cmtangeman/textmachine/README.md

# TextMachine
CrankPhone SW/FW/HW/Mech
Notes on directory structure:

FW:

ArduinoILI9341MKNNB1500 :  All for resistive touch FW (old)

capTouchTestingAndCal: testing calibration of capacitive touch

receiveSMSwithDebug:  debug file that doesn't need touchscreen

techmach: FW for old resistive screen

techmachcap: FW for current working capacitive touch screen.  See README.txt in this directory for further info.
