cmtangeman/textmachine/FW/UI_IMAGES/brightness_slider1.png

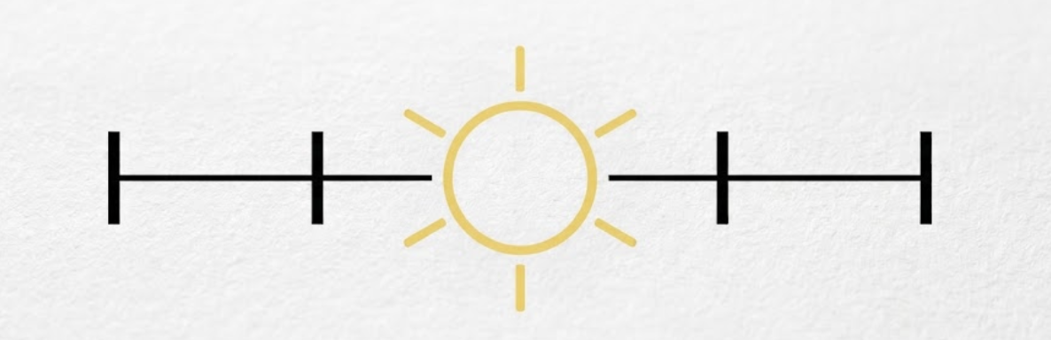
FW/UI_IMAGES/brightness_slider1.png
