cmtangeman/textmachine/FW/UI_IMAGES/compose.png

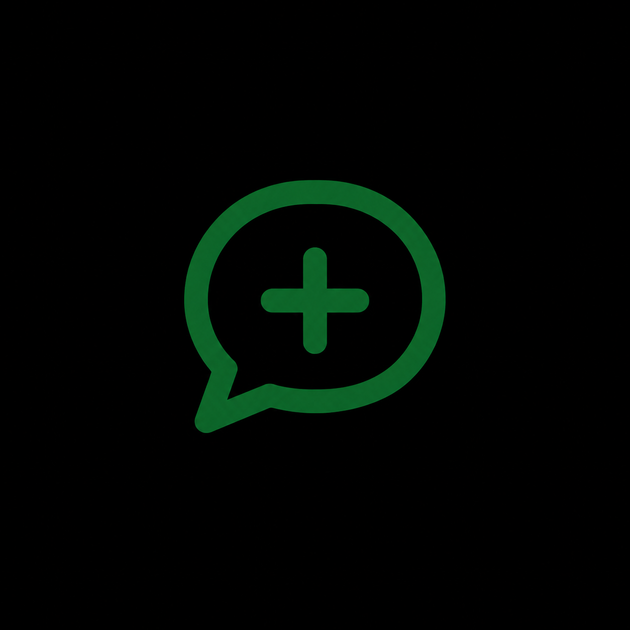
FW/UI_IMAGES/compose.png
