cmtangeman/textmachine/FW/UI_IMAGES/contacts.png

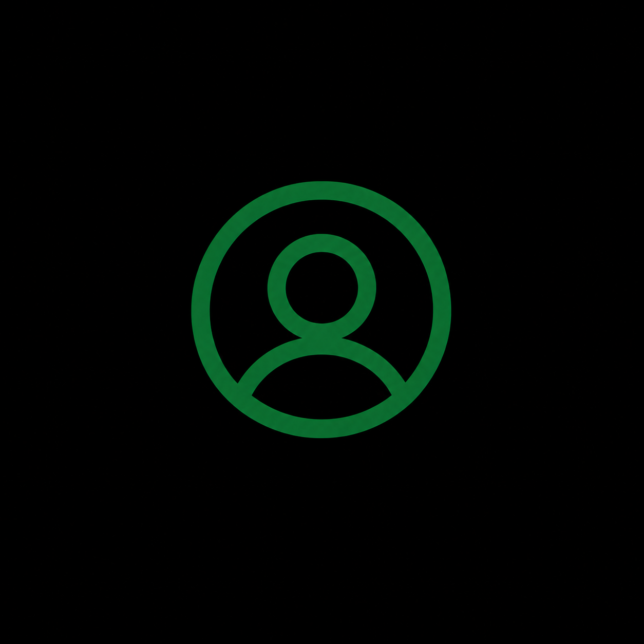
FW/UI_IMAGES/contacts.png
