cmtangeman/textmachine/FW/UI_IMAGES/contacts_only_mode_selector.png

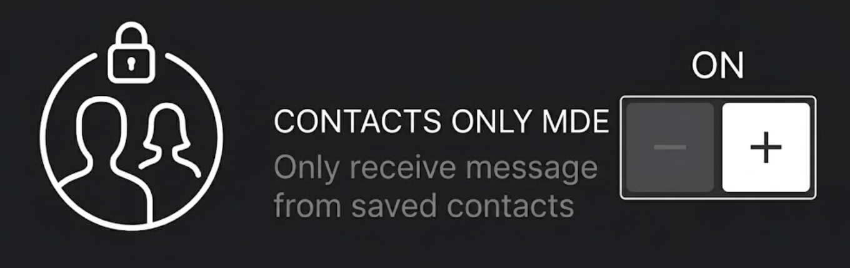
FW/UI_IMAGES/contacts_only_mode_selector.png
