cmtangeman/textmachine/FW/UI_IMAGES/swipe_indicator.png

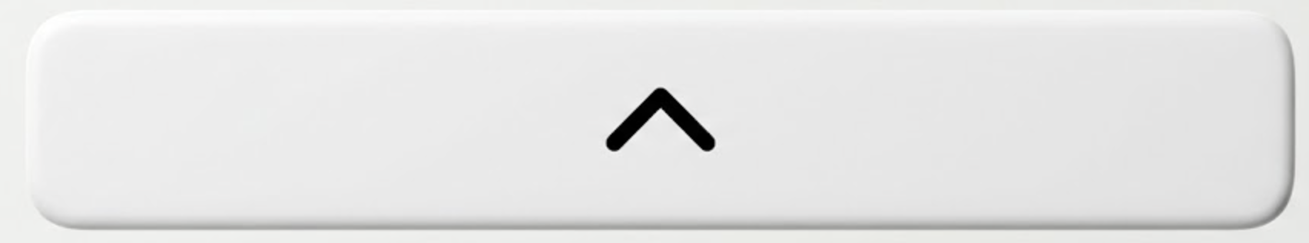
FW/UI_IMAGES/swipe_indicator.png
