cmtangeman/textmachine/(list of files, drawings)

Other design files:
HW/HA_FONA_LARA_20.dsn
