cmtangeman/textmachine/HW/HA_FONA_nonKiCad/HA_FONA_LARA_20.kicad_pcb

## KiCad design HW/HA_FONA_nonKiCad/HA_FONA_LARA_20.kicad_pcb (2026-10-18)

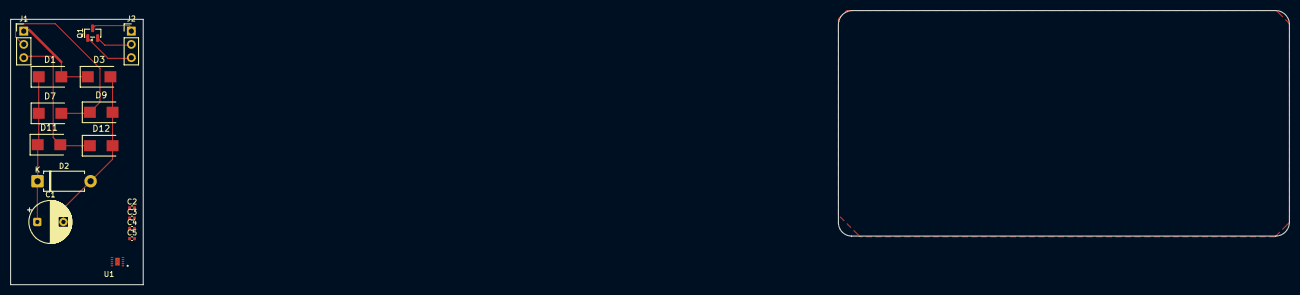
[picture p6: board HA_FONA_LARA_20.kicad_pcb from above]

Board: 2 copper layers, 25.4 x 50.8 mm, 16 parts (0 on the bottom side), 9 nets.

Parts:
C1: C_Polarized; CP_Radial_D8.0mm_P5.00mm
C2: 2.2u; C_0402_1005Metric
C3: 0.1u; C_0402_1005Metric
C4: 10u; C_0402_1005Metric
C5: 1u; C_0402_1005Metric
D1, D3, D7, D9, D11, D12: DIODE; DIOM5336X265N
D2: D; D_DO-15_P10.16mm_Horizontal
J1, J2: Conn_01x03_Pin; PinHeader_1x03_P2.54mm_Vertical
Q1: PMOS; SOT-23
U1: BQ25185DLHR; IC_BQ25185DLHR

Connections:
GND: C1.2, C2.1, C3.1, C4.2, D2.2 (A), D3.2 (A), D9.2 (A), D12.2 (A), U1.5 (GND)
unnamed: D1.2 (A), D3.1 (C), J1.1
unnamed: D7.2 (A), D9.1 (C), J1.2
unnamed: D11.2 (A), D12.1 (C), J1.3
unnamed: J2.1, Q1.3 (S)
unnamed: J2.2, Q1.2 (G)
unnamed: J2.3, Q1.1 (D)
unnamed: C4.1, U1.1 (SYS)
VBAT: C1.1, C2.2, C3.2, D1.1 (C), D2.1 (K), D7.1 (C), D11.1 (C), U1.10 (IN)
