cmtangeman/textmachine/HW/ported_textmachine_test (Copy)/ported_textmachine_test.kicad_pcb

## KiCad design HW/ported_textmachine_test (Copy)/ported_textmachine_test.kicad_pcb (2026-10-17)

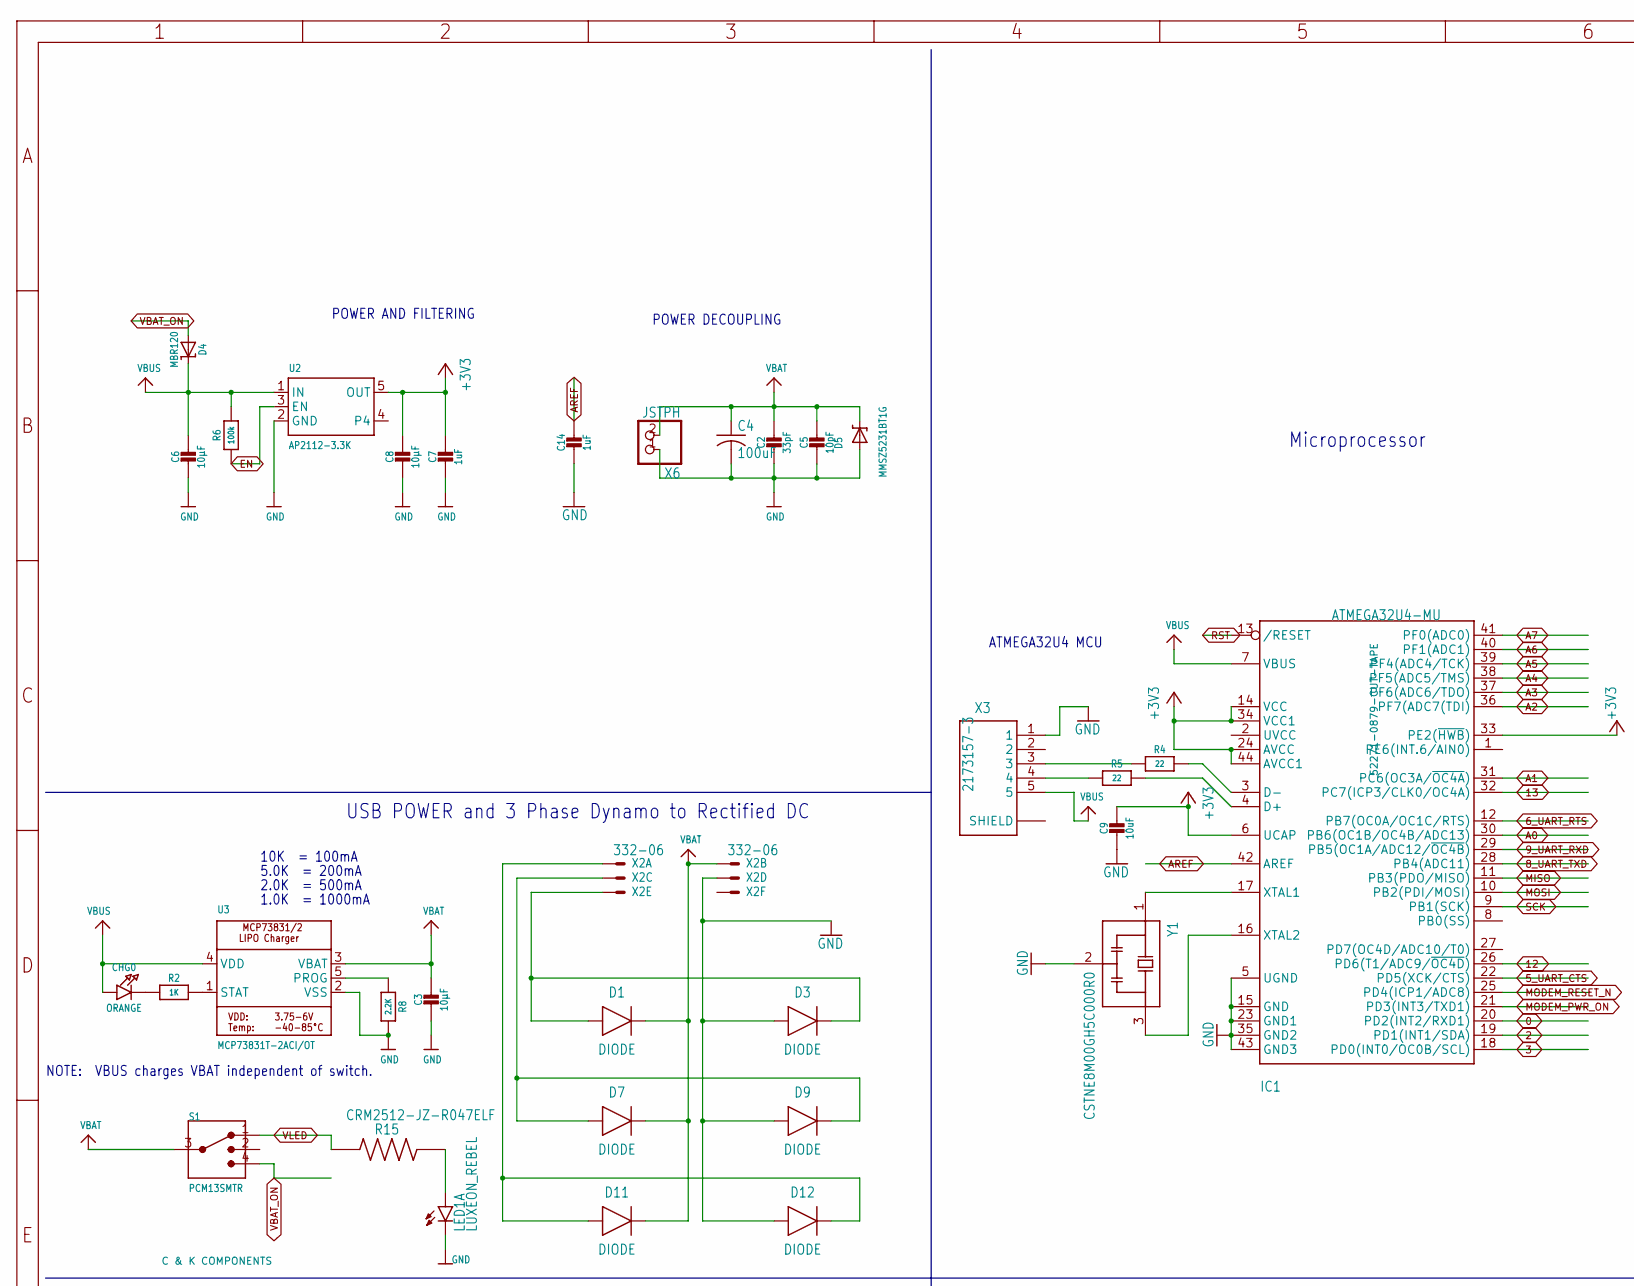
[picture p7: schematic ported_textmachine_test.kicad_sch, part in row 1, column 1]

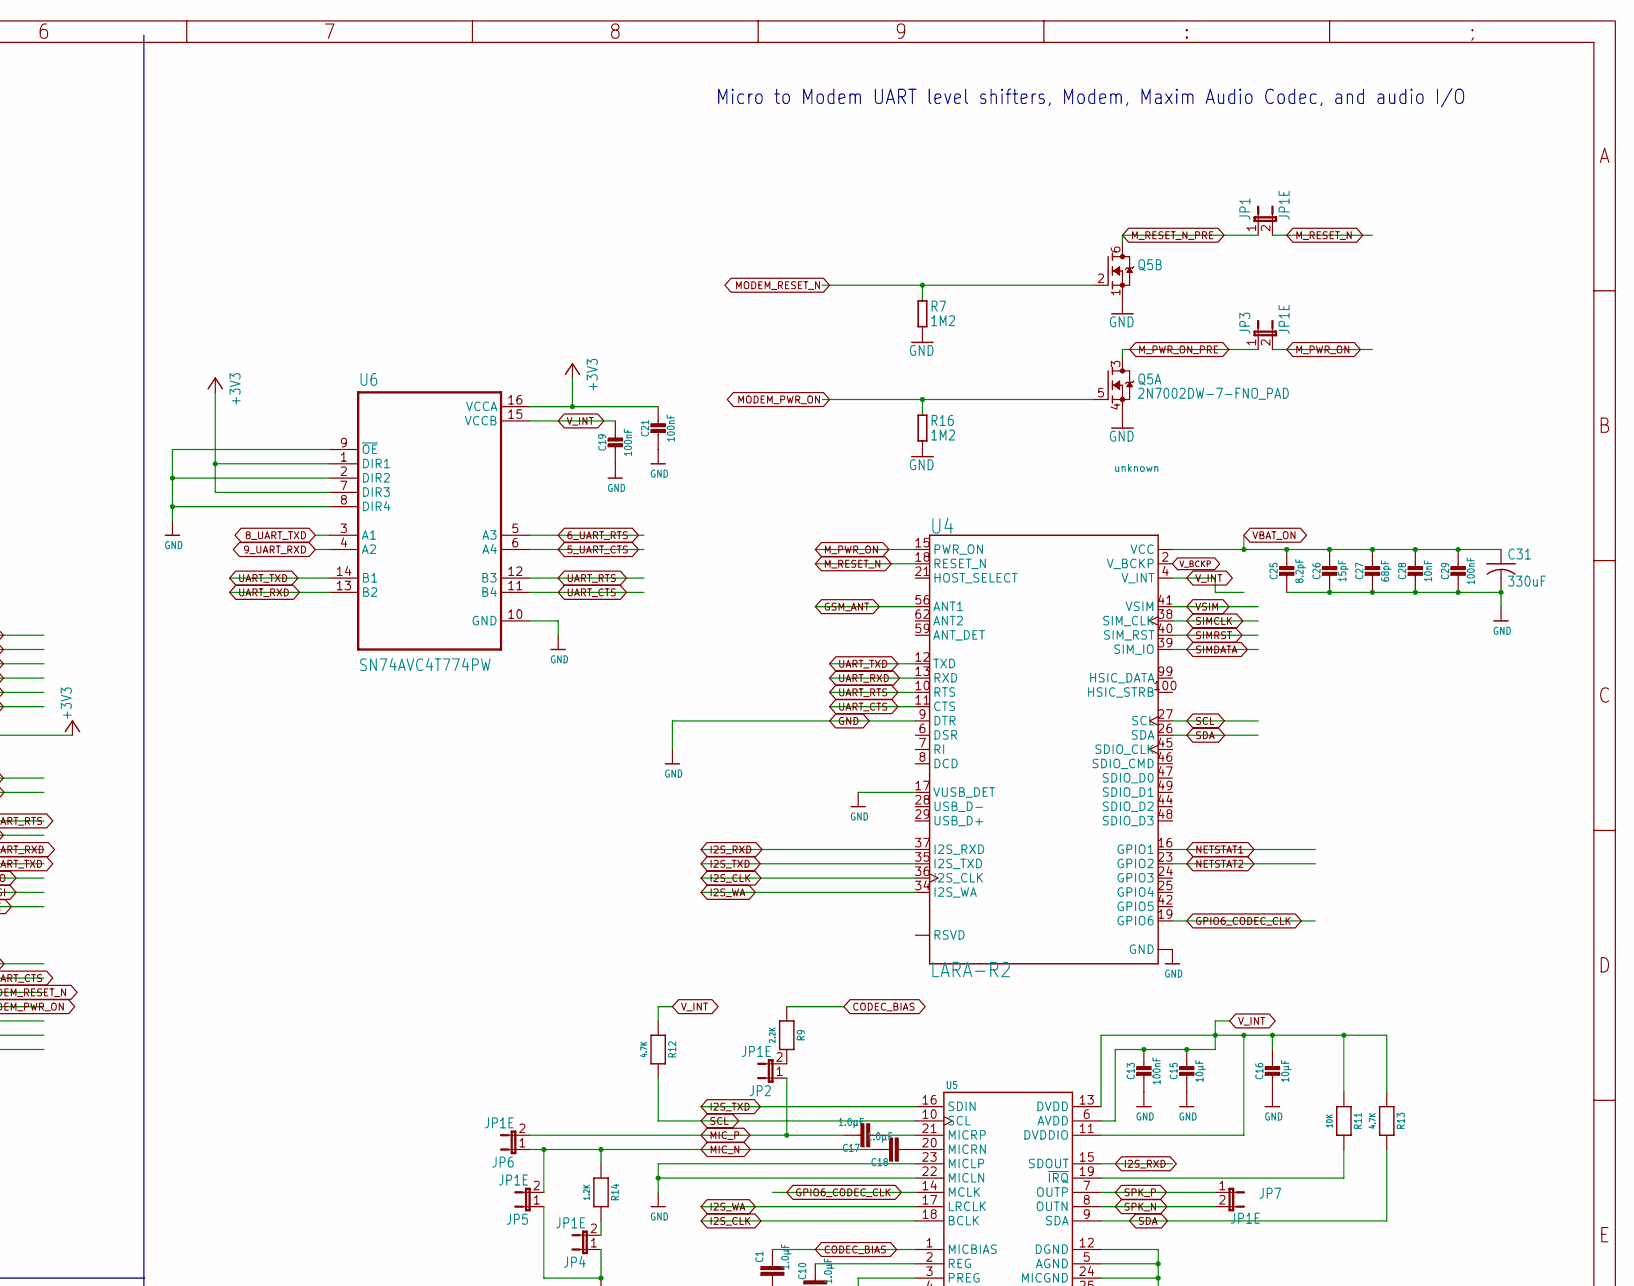
[picture p8: schematic ported_textmachine_test.kicad_sch, part in row 1, column 2]

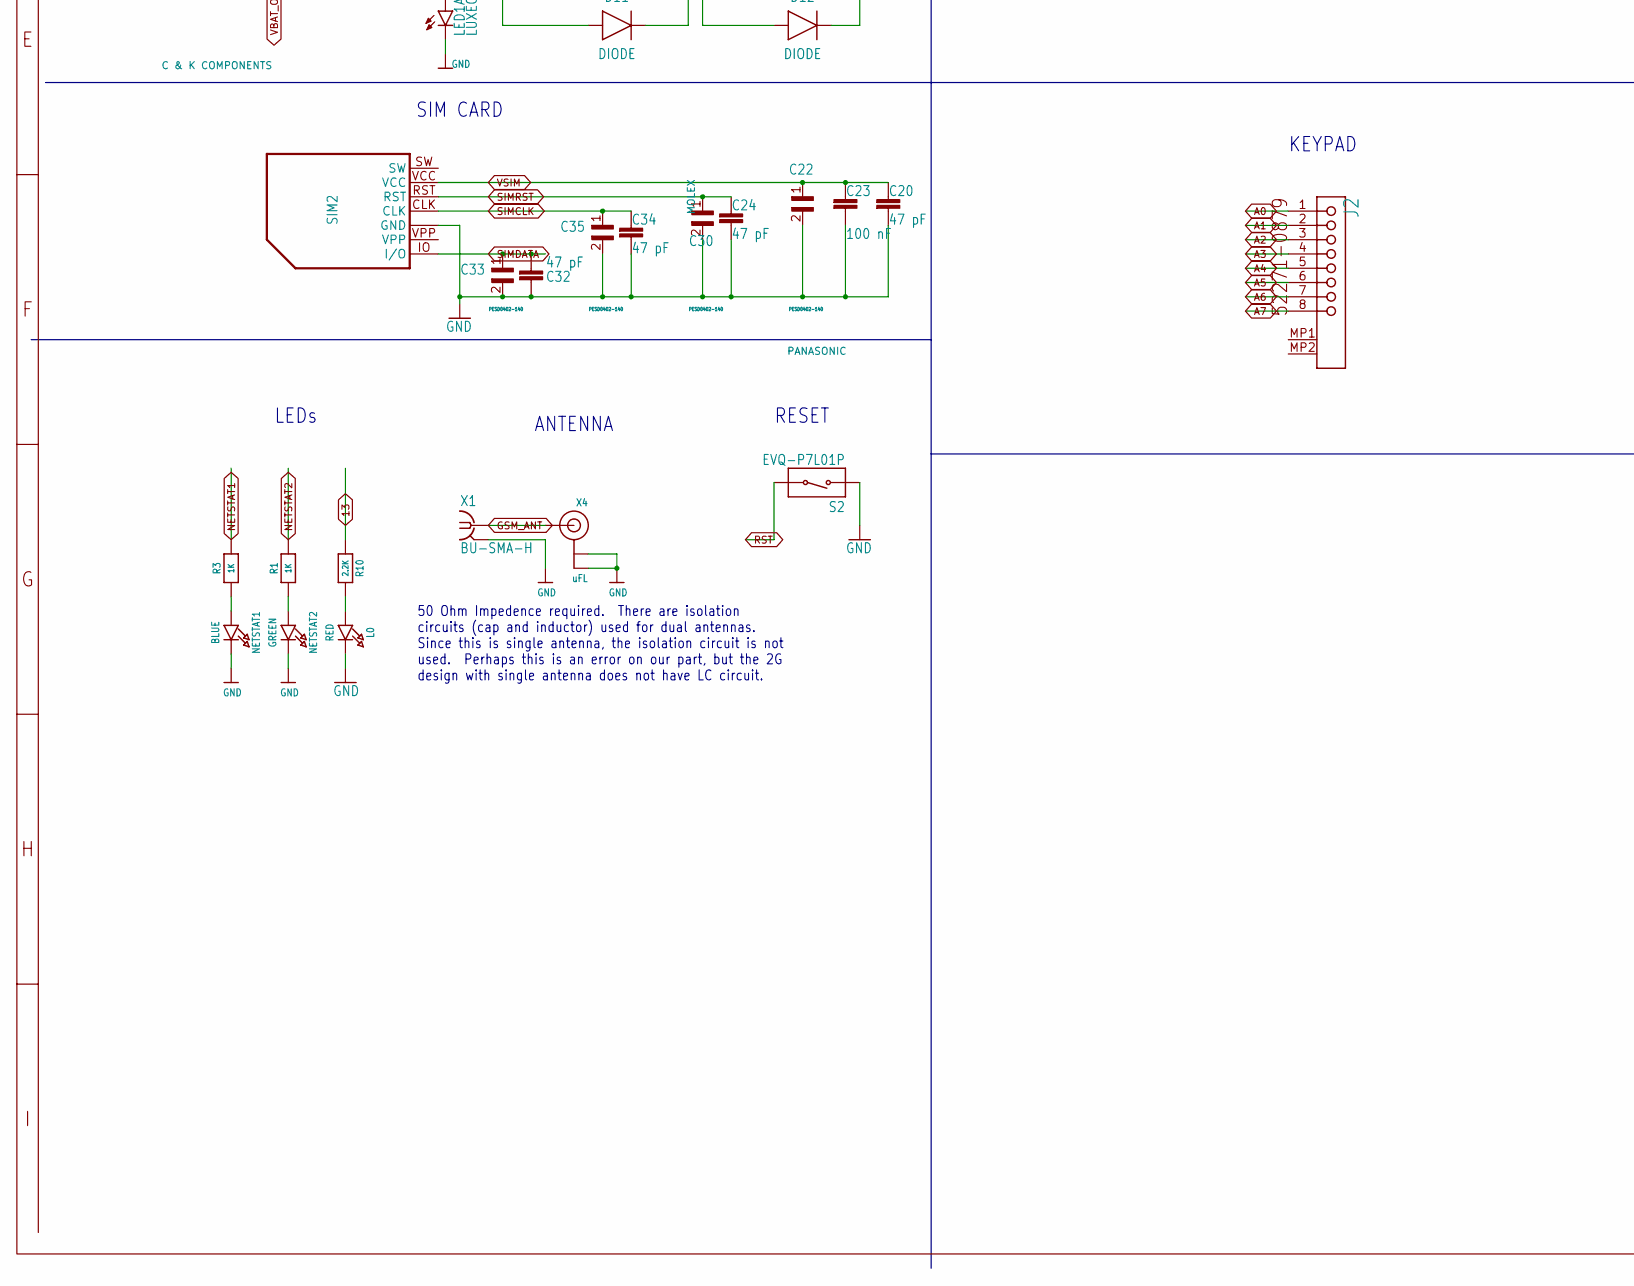
[picture p9: schematic ported_textmachine_test.kicad_sch, part in row 2, column 1]

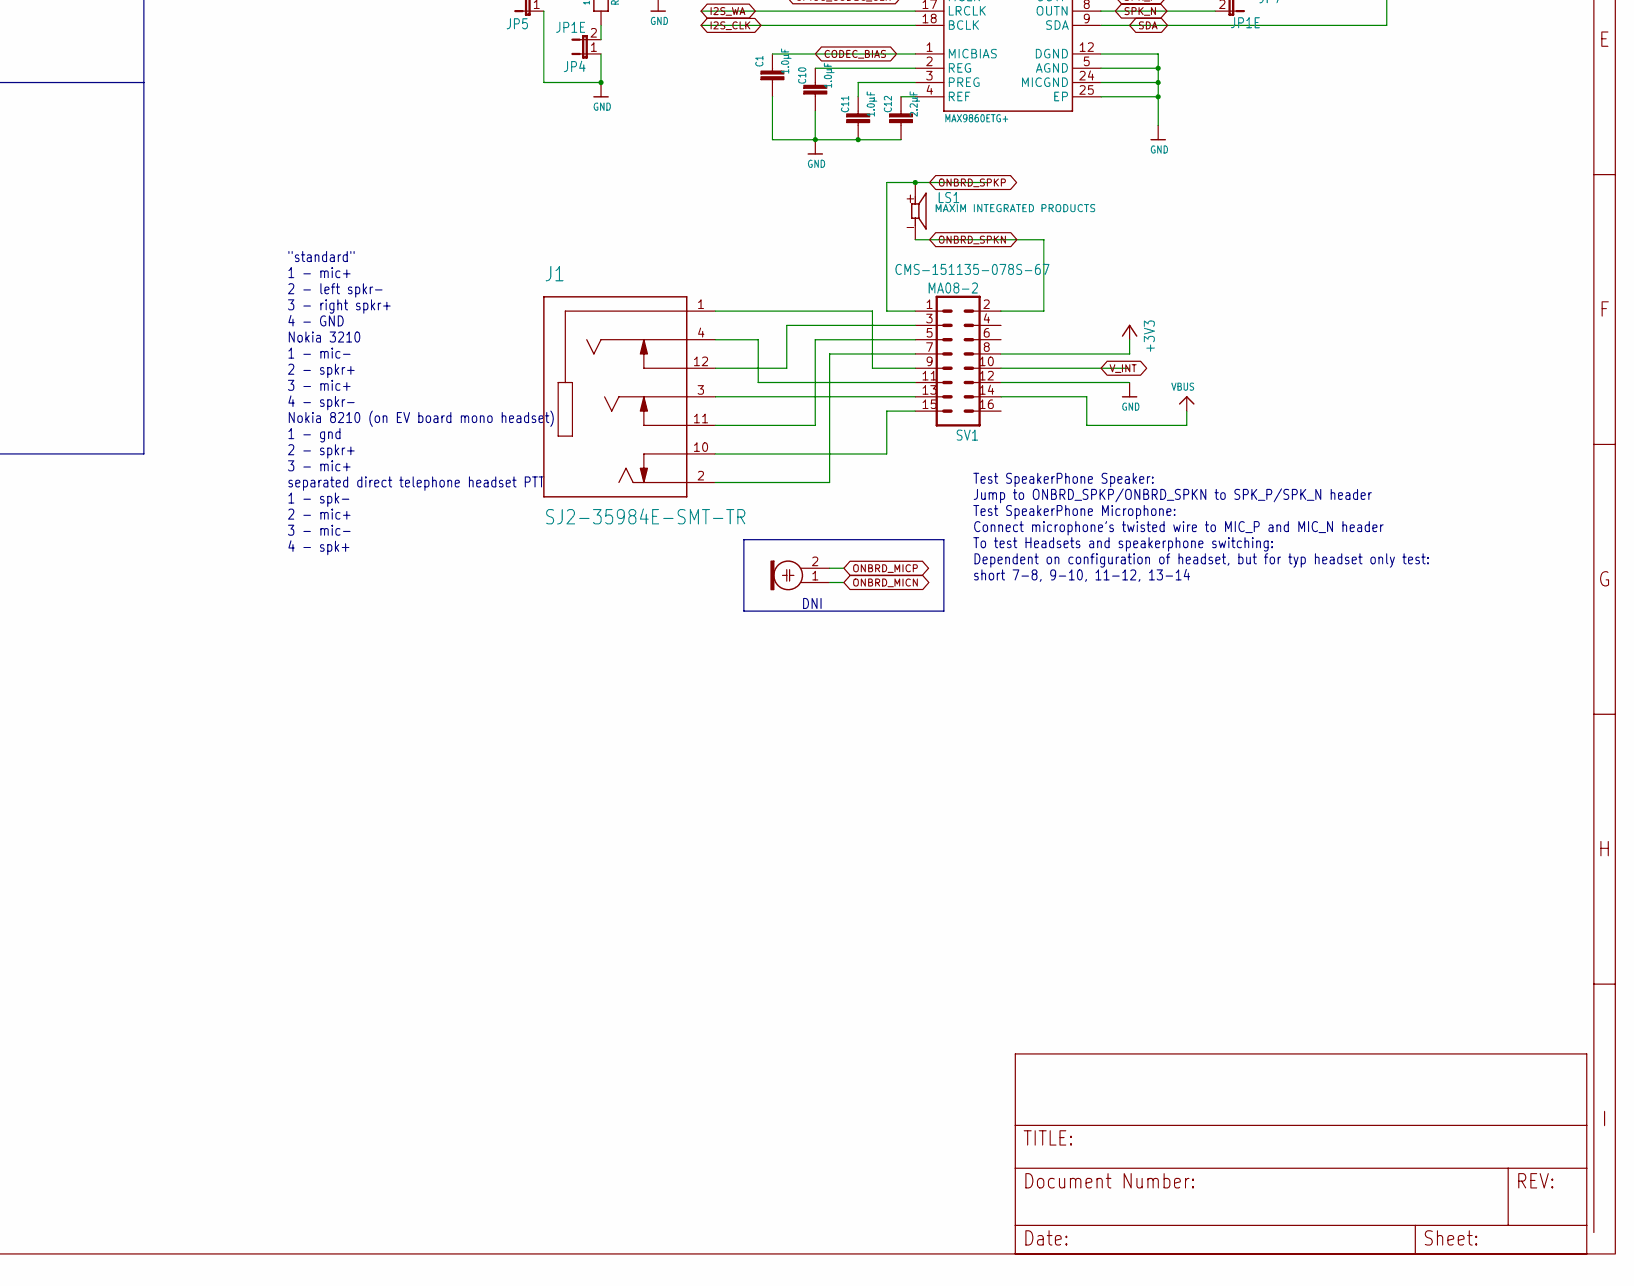
[picture p10: schematic ported_textmachine_test.kicad_sch, part in row 2, column 2]

Parts:
C1: 1.0µF; CAPC1005X60; MPN T491A225K016AT
C2: 33pF; 0805-NO; MPN 04025A330JAT2A
C3, C6, C8, C15, C16: 10µF; 0805-NO; MPN 08053D106KAT2A
C4: 100uF; C1210; MPN C1210C107M8PACTU
C5: 10pF; 0805-NO; MPN C0805C100D5GACTU
C7, C14: 1uF; 0603-NO; MPN 02016D104KAT2A
C9: 10uF; _0805MP; MPN 08053D106KAT2A
C10, C11, C17, C18: 1.0µF; CAPC1005X60; MPN 02016D104KAT2A
C12: 2.2µF; CAPC1608X85; MPN T491A225K016AT
C13: 100nF; 0805-NO; MPN 08055C104KAT2A
C19, C21, C29: 100nF; _0402; MPN C1005X7R1C104K050BC
C20, C24, C32, C34: 47 pF; CAPC1005X60
C22, C30, C33, C35: PESD0402-140; RESC1005X35N
C23: 100 nF; CAPC1005X60
C25: 8.2pF; _0402; MPN NMC0402NPO8R2C50TRPF
C26: 15pF; _0402; MPN MCMT15N150F500CT
C27: 68pF; _0402; MPN C0603C680J3GACAUTO
C28: 10nF; _0402; MPN 06035C103KAT2A
C31: 330uF; C1210; MPN GRM32EC80E337ME05L
CHG0: ORANGE; CHIPLED_0805_NOOUTLINE; MPN KPT-2012SECK
D1, D3, D7, D9, D11, D12: DIODE; DIOM5336X265N
D4: MBR120; SOD-123; MPN MBR120VLSFT1G
D5: MMSZ5231BT1G; SOD-123; MPN MMSZ5231BT1G
IC1: ATMEGA32U4-MU; TQFN44_7MM; MPN ATMEGA32U4-MU
J1: SJ2-35984E-SMT-TR; CUI_SJ2-35984E-SMT-TR
J2: MOLEX_52271-0879MOLEX_52271-0879_0_0; MOLEX_52271-0879_0; VOLTAGE_MAX 50V AC (RMS)/DC; MPN 52271-0879
JP1, JP2, JP3, JP4, JP5, JP6, JP7: JP1E; JP1
L0: RED; MICROBUILDER_CHIPLED_0603; MPN KPT-1608LVSECK-J3-PRV
LED1: LUXEON_REBEL
LS1: CMS-151135-078S-67; SPKR_CMS-151135-078S-67; PARTREV 1.0
M2: ELECTRET_MICROPHON-WM-61A; WM-61A
NETSTAT1: BLUE; CHIPLED_0805_NOOUTLINE; MPN KPT-2012LVVBC-D
NETSTAT2: GREEN; CHIPLED_0805_NOOUTLINE; MPN KPT-2012ZGCK
Q5: 2N7002DW-7-FNO_PAD; PWR_SC70-6L2
R1, R2, R3: 1K; 0603-NO; MPN ERJ3EKF1001V
R4, R5: 22; 0603-NO
R6: 100k; 0603-NO; MPN MCWR06X1003FTL
R7, R16: 1M2; 0402-1005X55N; MPN MCHVR02FTFY1204
R8, R9, R10: 2.2K; 0603-NO; MPN RC0603FR-072K2L.
R11: 10K; 0603-NO; MPN CRCW060310K0FKEA
R12, R13: 4.7K; 0603-NO; MPN ERJ-3EKF4701V
R14: 1.2K; 0603-NO; MPN CRCW06031K20FKEA
R15: CRM2512-JZ-R047ELF; RESC6331X80N
S1: PCM13SMTR; SW_PCM13SMTR; MPN PCM13SMTR; DIGI-KEY_PART_NUMBER 401-2017-1-ND
S2: EVQ-P7L01P; SW_EVQ-P7L01P; MPN EVQP7L01P
SIM2: -; MICROSIM8
SV1: MA08-2
U2: AP2112-3.3K; SOT23-5
U3: MCP73831T-2ACI/OT; SOT23-5; MPN MCP73831T-2ACI/OT
U4: LARA-R2; XCVR_LARA-R2
U5: MAX9860ETG+; QFN50P400X400X75-25N; MPN MAX9860ETG+
U6: SN74AVC4T774PW; SOP65P640X120-16N
X1: BU-SMA-H
X2: 332-06
X3: 2173157-3; CONN_2173157-3
X4: uFL; U.FL; MPN U.FL-R-SMT-1(10)
X6: JSTPH; JSTPH2
Y1: CSTNE8M00GH5C000R0; OSC_CSTNE8M00GH5C000R0

Connections:
0: IC1.20 (PD2(INT2/RXD1))
2: IC1.19 (PD1(INT1/SDA))
3: IC1.18 (PD0(INT0/OC0B/SCL))
5_UART_CTS: IC1.22 (PD5(XCK/CTS)), U6.6 (A4)
6_UART_RTS: IC1.12 (PB7(OC0A/OC1C/RTS)), U6.5 (A3)
8_UART_TXD: IC1.28 (PB4(ADC11)), U6.3 (A1)
9_UART_RXD: IC1.29 (PB5(OC1A/ADC12/~OC4B)), U6.4 (A2)
12: IC1.26 (PD6(T1/ADC9/~OC4D))
13: IC1.32 (PC7(ICP3/CLK0/OC4A)), R10.1
+3V3: C7.1, C8.1, C9.1, C21.1, IC1.6 (UCAP), IC1.14 (VCC), IC1.24 (AVCC), IC1.33 (PE2(~HWB)), IC1.34 (VCC1), IC1.44 (AVCC1), SV1.8, U2.5 (OUT), U6.1 (DIR1), U6.7 (DIR3), U6.16 (VCCA)
A0: IC1.30 (PB6(OC1B/OC4B/ADC13)), J2.1
A1: IC1.31 (PC6(OC3A/~OC4A)), J2.2
A2: IC1.36 (PF7(ADC7(TDI)), J2.3
A3: IC1.37 (PF6(ADC6/TDO)), J2.4
A4: IC1.38 (PF5(ADC5/TMS)), J2.5
A5: IC1.39 (PF4(ADC4/TCK)), J2.6
A6: IC1.40 (PF1(ADC1)), J2.7
A7: IC1.41 (PF0(ADC0)), J2.8
AREF: C14.1, IC1.42 (AREF)
CODEC_BIAS: C1.1, R9.1, U5.1 (MICBIAS)
D+: IC1.4 (D+), R5.2
D-: IC1.3 (D-), R4.2
EN: R6.1, U2.3 (EN)
GND: C1.2, C2.2, C3.2, C4.2, C5.2, C6.2, C7.2, C8.2, C9.2, C10.2, C11.2, C12.2, C13.2, C14.2, C15.2, C16.2, C19.2, C20.2, C21.2, C22.2, C23.2, C24.2, C25.2, C26.2, C27.2, C28.2, C29.2, C30.2, C31.2, C32.2, C33.2, C34.2, C35.2, D3.2 (A), D5.A, D9.2 (A), D12.2 (A), IC1.5 (UGND), IC1.15 (GND), IC1.23 (GND1), IC1.35 (GND2), IC1.43 (GND3), JP4.1, JP5.1, L0.C, LED1.C, LED1.C@1 (C), NETSTAT1.C, NETSTAT2.C, Q5.1 (S), Q5.4 (S), R7.1, R8.2, R16.1, S2.1_1 (1), S2.1_2 (1), SIM2.GND, SIM2.SH1 (GND), SIM2.SH2 (GND), SIM2.SH3 (GND), SIM2.SH4 (GND), SIM2.SH5 (GND), SV1.12, U2.2 (GND), U3.2 (VSS), U4.1 (GND), U4.3 (GND), U4.5 (GND), U4.9 (DTR), U4.14 (GND), U4.17 (VUSB_DET), U4.20 (GND), U4.22 (GND), U4.30 (GND), U4.32 (GND), U4.43 (GND), U4.50 (GND), U4.54 (GND), U4.55 (GND), U4.57 (GND), U4.58 (GND), U4.60 (GND), U4.61 (GND), U4.63 (GND), U4.64 (GND), U4.65 (GND), U4.66 (GND), U4.67 (GND), U4.68 (GND), U4.69 (GND), U4.70 (GND), U4.71 (GND), U4.72 (GND), U4.73 (GND), U4.74 (GND), U4.75 (GND), U4.76 (GND), U4.77 (GND), U4.78 (GND), U4.79 (GND), U4.80 (GND), U4.81 (GND), U4.82 (GND), U4.83 (GND), U4.84 (GND), U4.85 (GND), U4.86 (GND), U4.87 (GND), U4.88 (GND), U4.89 (GND), U4.90 (GND), U4.91 (GND), U4.92 (GND), U4.93 (GND), U4.94 (GND), U4.95 (GND), U4.96 (GND), U5.5 (AGND), U5.12 (DGND), U5.22 (MICLN), U5.23 (MICLP), U5.24 (MICGND), U5.25 (EP), U6.2 (DIR2), U6.8 (DIR4), U6.9 (~OE), U6.10 (GND), X1.2, X1.3 (2), X1.4 (2), X1.5 (2), X2.4, X3.1, X4.1 (GND), X4.2 (GND), X6.1, Y1.2 (GND)
GPIO6_CODEC_CLK: U4.19 (GPIO6), U5.14 (MCLK)
GSM_ANT: U4.56 (ANT1), X1.1, X4.3 (SIGNAL)
I2S_CLK: U4.36 (I2S_CLK), U5.18 (BCLK)
I2S_RXD: U4.37 (I2S_RXD), U5.15 (SDOUT)
I2S_TXD: U4.35 (I2S_TXD), U5.16 (SDIN)
I2S_WA: U4.34 (I2S_WA), U5.17 (LRCLK)
MIC_N: C18.1, JP5.2, JP6.1, R14.1
MIC_P: C17.1, JP2.1, JP6.2
MISO: IC1.11 (PB3(PDO/MISO))
MODEM_PWR_ON: IC1.21 (PD3(INT3/TXD1)), Q5.5 (G), R16.2
MODEM_RESET_N: IC1.25 (PD4(ICP1/ADC8)), Q5.2 (G), R7.2
MOSI: IC1.10 (PB2(PDI/MOSI))
M_PWR_ON: JP3.2, U4.15 (PWR_ON)
M_PWR_ON_PRE: JP3.1, Q5.3 (D)
M_RESET_N: JP1.2, U4.18 (RESET_N)
M_RESET_N_PRE: JP1.1, Q5.6 (D)
unnamed: CHG0.C, R2.1
unnamed: L0.A, R10.2
unnamed: R2.2, U3.1 (STAT)
unnamed: R8.1, U3.5 (PROG)
unnamed: NETSTAT2.A, R1.1
unnamed: D11.2 (A), D12.1 (C), X2.1
unnamed: C17.2, U5.21 (MICRP)
unnamed: NETSTAT1.A, R3.1
unnamed: C12.1, U5.4 (REF)
unnamed: IC1.16 (XTAL2), Y1.3 (OUT)
unnamed: IC1.17 (XTAL1), Y1.1 (IN)
unnamed: C11.1, U5.3 (PREG)
unnamed: C10.1, U5.2 (REG)
unnamed: R5.1, X3.4
unnamed: R4.1, X3.3
unnamed: C18.2, U5.20 (MICRN)
unnamed: R11.2, U5.19 (~IRQ)
unnamed: JP2.2, R9.2
unnamed: JP4.2, R14.2
unnamed: D7.2 (A), D9.1 (C), X2.3
unnamed: D1.2 (A), D3.1 (C), X2.5
unnamed: J1.11 (RING1_SWITCH), SV1.5
unnamed: LED1.A, LED1.A@1 (A), R15.2
unnamed: J1.12 (RING2_SWITCH), SV1.3
unnamed: J1.2 (TIP), SV1.7
unnamed: J1.1 (SLEEVE), SV1.9
unnamed: J1.4 (RING2), SV1.11
unnamed: J1.3 (RING1), SV1.13
unnamed: J1.10 (TIP_SWITCH), SV1.15
NETSTAT1: R3.2, U4.16 (GPIO1)
NETSTAT2: R1.2, U4.23 (GPIO2)
ONBRD_MICN: M2.1
ONBRD_MICP: M2.2
ONBRD_SPKN: LS1.M, SV1.2
ONBRD_SPKP: LS1.P, SV1.1
RST: IC1.13 (/RESET), S2.2_1 (2), S2.2_2 (2)
SCK: IC1.9 (PB1(SCK))
SCL: R12.2, U4.27 (SCL), U5.10 (SCL)
SDA: R13.2, U4.26 (SDA), U5.9 (SDA)
SIMCLK: C34.1, C35.1, SIM2.CLK, U4.38 (SIM_CLK)
SIMDATA: C32.1, C33.1, SIM2.IO (I/O), U4.39 (SIM_IO)
SIMRST: C24.1, C30.1, SIM2.RST, U4.40 (SIM_RST)
SPK_N: JP7.2, U5.8 (OUTN)
SPK_P: JP7.1, U5.7 (OUTP)
UART_CTS: U4.11 (CTS), U6.11 (B4)
UART_RTS: U4.10 (RTS), U6.12 (B3)
UART_RXD: U4.13 (RXD), U6.13 (B2)
UART_TXD: U4.12 (TXD), U6.14 (B1)
VBAT: C2.1, C3.1, C4.1, C5.1, D1.1 (C), D5.C, D7.1 (C), D11.1 (C), S1.3, U3.3 (VBAT), X2.2, X6.2
VBAT_ON: C25.1, C26.1, C27.1, C28.1, C29.1, C31.1, D4.A, S1.4, U4.51 (VCC), U4.52 (VCC), U4.53 (VCC)
VBUS: C6.1, CHG0.A, D4.C, IC1.7 (VBUS), R6.2, SV1.14, U2.1 (IN), U3.4 (VDD), X3.5
VLED: R15.1, S1.1
VSIM: C20.1, C22.1, C23.1, SIM2.VCC, U4.41 (VSIM)
V_BCKP: U4.2 (V_BCKP)
V_INT: C13.1, C15.1, C16.1, C19.1, R11.1, R12.1, R13.1, SV1.10, U4.4 (V_INT), U5.6 (AVDD), U5.11 (DVDDIO), U5.13 (DVDD), U6.15 (VCCB)

Notes on the sheet:
Microprocessor
POWER DECOUPLING
KEYPAD
Micro to Modem UART level shifters, Modem, Maxim Audio Codec, and audio I/O
2.0K = 500mA
1.0K = 1000mA
LEDs
50 Ohm Impedence required. There are isolation circuits (cap and inductor) used for dual antennas. Since this is single antenna, the isolation circuit is not used. Perhaps this is an error on our part, but the 2G design with single antenna does not have LC circuit.
SIM CARD
RESET
5.0K = 200mA
DNI
NOTE: VBUS charges VBAT independent of switch.
Test SpeakerPhone Speaker: Jump to ONBRD_SPKP/ONBRD_SPKN to SPK_P/SPK_N header Test SpeakerPhone Microphone: Connect microphone's twisted wire to MIC_P and MIC_N header To test Headsets and speakerphone switching: Dependent on configuration of headset, but for typ headset only test: short 7-8, 9-10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
USB POWER and 3 Phase Dynamo to Rectified DC
POWER AND FILTERING
ANTENNA
ATMEGA32U4 MCU
"standard" 1 - mic+ 2 - left spkr- 3 - right spkr+ 4 - GND Nokia 3210 1 - mic- 2 - spkr+ 3 - mic+ 4 - spkr- Nokia 8210 (on EV board mono headset) 1 - gnd 2 - spkr+ 3 - mic+ separated direct telephone headset PTT 1 - spk- 2 - mic+ 3 - mic- 4 - spk+
10K = 100mA

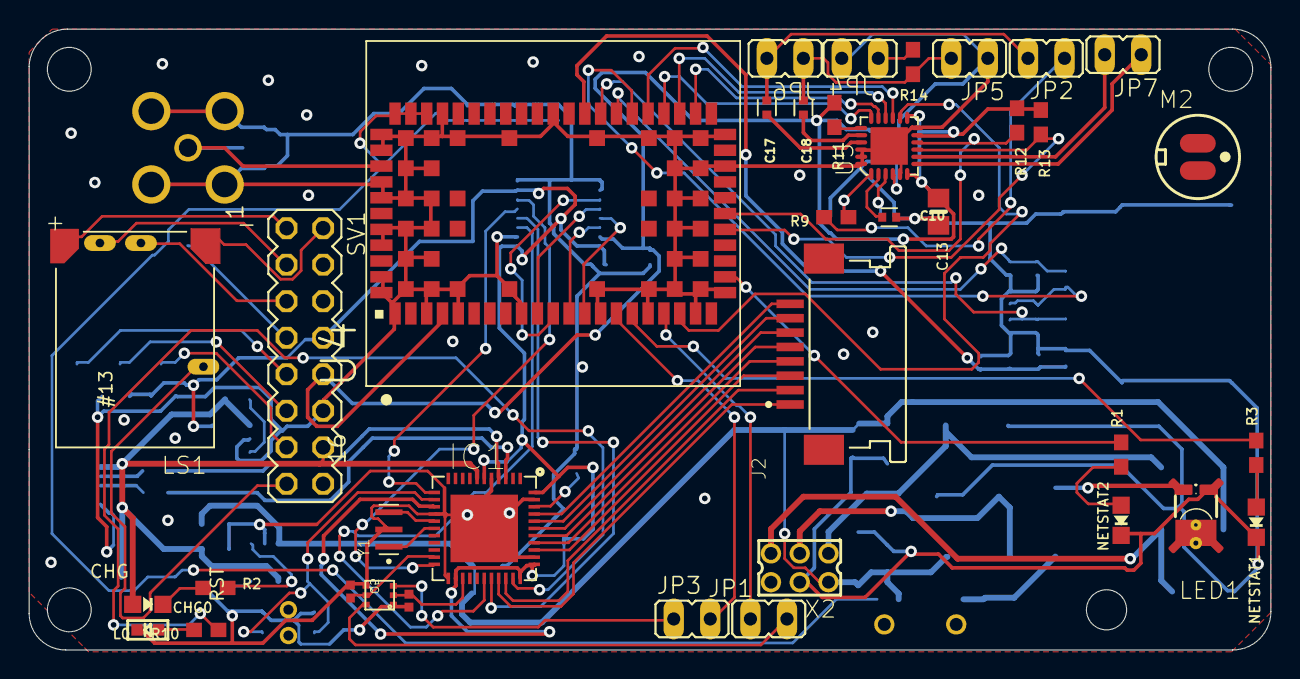
[picture p11: board ported_textmachine_test.kicad_pcb from above]

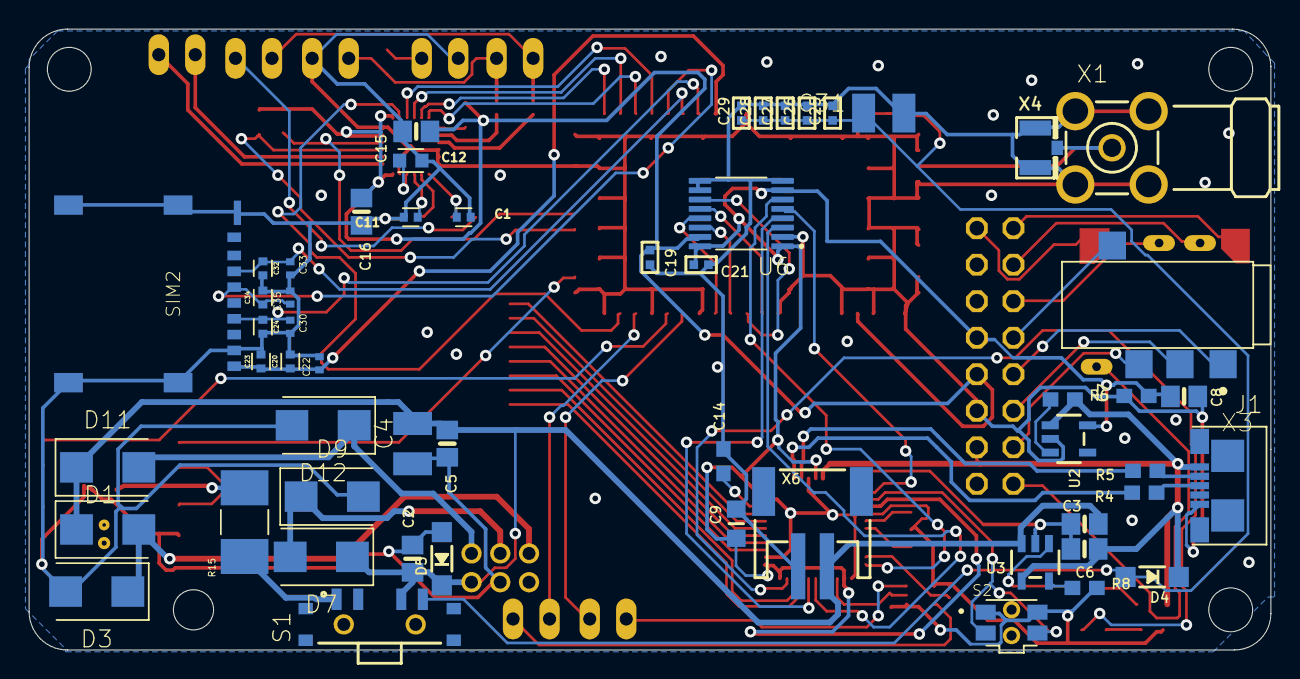
[picture p12: board ported_textmachine_test.kicad_pcb from below]

Board: 2 copper layers, 86.4 x 43.2 mm, 96 parts (55 on the bottom side), 85 nets.

Other parts of the board:
UNK_HOLE_0: dummyfp0
UNK_HOLE_1: dummyfp1
UNK_HOLE_2: dummyfp2
UNK_HOLE_3: dummyfp3
