cmtangeman/textmachine/FW/textmachcap/nav_icons.h

#pragma once
#include <Arduino.h>

// 1-bit masks for the home-screen nav grid, thresholded (96x96, PIL,
// grayscale >= 60 = ink) from the matching UI_IMAGES/*.png at build time —
// same convention as splash_logo.h. Drawn via tft.drawBitmap(x, y, bits, W,
// H, color) in the single-color overload, which only paints the "1" bits
// (transparent background), so these can be stamped straight onto a tile
// that's already been filled with UI_BG/UI_SURFACE.

// Messages / recents tab — thresholded from UI_IMAGES/recents.png at build time
#define RECENTS_ICON_W 96
#define RECENTS_ICON_H 96
static const uint8_t PROGMEM RECENTS_ICON_bits[] = {
  0x00, 0x00, 0x00, 0x00, 0x00, 0x00, 0x00, 0x00, 0x00, 0x00, 0x00, 0x00, 0x00, 0x00, 0x00, 0x00,
  0x00, 0x00, 0x00, 0x00, 0x00, 0x00, 0x00, 0x00, 0x00, 0x00, 0x00, 0x00, 0x00, 0x00, 0x00, 0x00,
  0x00, 0x00, 0x00, 0x00, 0x00, 0x00, 0x00, 0x00, 0x00, 0x00, 0x00, 0x00, 0x00, 0x00, 0x00, 0x00,
  0x00, 0x00, 0x00, 0x00, 0x00, 0x00, 0x00, 0x00, 0x00, 0x00, 0x00, 0x00, 0x00, 0x00, 0x00, 0x00,
  0x00, 0x00, 0x00, 0x00, 0x00, 0x00, 0x00, 0x00, 0x00, 0x00, 0x00, 0x00, 0x00, 0x00, 0x00, 0x00,
  0x00, 0x00, 0x00, 0x00, 0x00, 0x00, 0x00, 0x00, 0x00, 0x00, 0x00, 0x00, 0x00, 0x00, 0x00, 0x00,
  0x00, 0x00, 0x00, 0x00, 0x00, 0x00, 0x00, 0x00, 0x00, 0x00, 0x00, 0x00, 0x00, 0x00, 0x00, 0x00,
  0x00, 0x00, 0x00, 0x00, 0x00, 0x00, 0x00, 0x00, 0x00, 0x00, 0x00, 0x00, 0x00, 0x00, 0x00, 0x00,
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
  0x30, 0x00, 0x00, 0x00, 0x00, 0x00, 0x00, 0x0C, 0x10, 0x40, 0x02, 0x08, 0x30, 0x00, 0x00, 0x00,
  0x00, 0x00, 0x00, 0x0C, 0x10, 0x60, 0x06, 0x18, 0x60, 0x00, 0x00, 0x00, 0x00, 0x00, 0x00, 0x06,
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
};
