cmtangeman/textmachine/FW/textmachcap/settings_icons.h

#pragma once
#include <Arduino.h>

// 1-bit mask for the Settings screen's "Contacts Only Mode" row icon,
// thresholded (56x56, PIL, grayscale >= 60 = ink) from the lock+people
// portion of UI_IMAGES/contacts_only_mode_selector.png at build time — same
// convention as nav_icons.h. Drawn via tft.drawBitmap(x, y, bits, W, H,
// color) in the single-color overload (transparent background).

// Contacts Only Mode row icon — thresholded from UI_IMAGES/contacts_only_mode_selector.png at build time
#define CONTACTS_ONLY_ICON_W 56
#define CONTACTS_ONLY_ICON_H 56
static const uint8_t PROGMEM CONTACTS_ONLY_ICON_bits[] = {
  0x00, 0x00, 0x00, 0x00, 0x00, 0x00, 0x00, 0x00, 0x00, 0x00, 0x00, 0x00, 0x00, 0x00, 0x00, 0x00,
  0x00, 0x00, 0x00, 0x00, 0x00, 0x00, 0x00, 0x00, 0x00, 0x00, 0x00, 0x00, 0x00, 0x00, 0x00, 0x0E,
  0x00, 0x00, 0x00, 0x00, 0x00, 0x00, 0x1F, 0x00, 0x00, 0x00, 0x00, 0x00, 0x00, 0x31, 0x80, 0x00,
  0x00, 0x00, 0x00, 0x00, 0x31, 0x80, 0x00, 0x00, 0x00, 0x00, 0x00, 0x21, 0x80, 0x00, 0x00, 0x00,
  0x00, 0x00, 0x7F, 0xC0, 0x00, 0x00, 0x00, 0x00, 0x00, 0xFF, 0xE0, 0x00, 0x00, 0x00, 0x00, 0x1C,
  0xC0, 0x67, 0x00, 0x00, 0x00, 0x00, 0x3C, 0xCE, 0x67, 0x80, 0x00, 0x00, 0x00, 0xE0, 0xCC, 0x61,
  0xE0, 0x00, 0x00, 0x01, 0xC0, 0xC4, 0x60, 0x70, 0x00, 0x00, 0x03, 0x80, 0xC0, 0x60, 0x38, 0x00,
  0x00, 0x07, 0x00, 0xFF, 0xE0, 0x1C, 0x00, 0x00, 0x0E, 0x00, 0x7F, 0xC0, 0x0E, 0x00, 0x00, 0x0C,
  0x00, 0x00, 0x00, 0x06, 0x00, 0x00, 0x18, 0x00, 0x00, 0x00, 0x03, 0x00, 0x00, 0x38, 0x1F, 0xC0,
  0x00, 0x03, 0x00, 0x00, 0x30, 0x3F, 0xE0, 0x0E, 0x01, 0x80, 0x00, 0x30, 0x70, 0x30, 0x3F, 0x81,
  0x80, 0x00, 0x60, 0x60, 0x30, 0x71, 0x80, 0xC0, 0x00, 0x60, 0x60, 0x18, 0x60, 0xC0, 0xC0, 0x00,
  0x60, 0x60, 0x18, 0x60, 0xC0, 0xC0, 0x00, 0x60, 0x60, 0x18, 0x60, 0xC0, 0xC0, 0x00, 0x60, 0x60,
  0x18, 0x60, 0xC0, 0xC0, 0x00, 0x60, 0x60, 0x18, 0x60, 0xC0, 0xC0, 0x00, 0x60, 0x60, 0x38, 0xC0,
  0x60, 0xC0, 0x00, 0x60, 0x60, 0x30, 0xF1, 0xE0, 0xC0, 0x00, 0x60, 0x30, 0x30, 0x7B, 0x80, 0xC0,
  0x00, 0x60, 0x38, 0x60, 0x3B, 0x00, 0xC0, 0x00, 0x60, 0x18, 0xC0, 0xF1, 0xE0, 0xC0, 0x00, 0x70,
  0x18, 0xC1, 0xE0, 0xF1, 0x80, 0x00, 0x30, 0x38, 0x71, 0x00, 0x19, 0x80, 0x00, 0x31, 0xF0, 0x3C,
  0x00, 0x1B, 0x80, 0x00, 0x1B, 0xC0, 0x0F, 0x00, 0x03, 0x00, 0x00, 0x1E, 0x00, 0x03, 0x80, 0x07,
  0x00, 0x00, 0x0C, 0x00, 0x00, 0xC0, 0x06, 0x00, 0x00, 0x06, 0x00, 0x00, 0xC0, 0x0C, 0x00, 0x00,
  0x03, 0x00, 0x00, 0xE0, 0x18, 0x00, 0x00, 0x01, 0x80, 0x00, 0x60, 0x30, 0x00, 0x00, 0x00, 0xE0,
  0x00, 0x60, 0xE0, 0x00, 0x00, 0x00, 0x70, 0x00, 0x63, 0xC0, 0x00, 0x00, 0x00, 0x3E, 0x00, 0x4F,
  0x80, 0x00, 0x00, 0x00, 0x0F, 0xE0, 0xFE, 0x00, 0x00, 0x00, 0x00, 0x01, 0xFF, 0xF0, 0x00, 0x00,
  0x00, 0x00, 0x00, 0x0F, 0x00, 0x00, 0x00, 0x00, 0x00, 0x00, 0x00, 0x00, 0x00, 0x00, 0x00, 0x00,
  0x00, 0x00, 0x00, 0x00, 0x00, 0x00, 0x00, 0x00, 0x00, 0x00, 0x00, 0x00, 0x00, 0x00, 0x00, 0x00,
  0x00, 0x00, 0x00, 0x00, 0x00, 0x00, 0x00, 0x00, 0x00, 0x00, 0x00, 0x00, 0x00, 0x00, 0x00, 0x00,
  0x00, 0x00, 0x00, 0x00, 0x00, 0x00, 0x00, 0x00,
};
