cmtangeman/textmachine/FW/ArduinoILI9341MKNNB1500/CrankTextSend-Receive1.0/Messages.h

#ifndef MESSAGES_H
#define MESSAGES_H

#include <Arduino.h>
#include "buttons.h"   // <-- gives ScreenPoint

#define MAX_CONVERSATIONS 10
#define MAX_MESSAGES_PER_CONVO 20
#define MAX_PHONE_LEN 20
#define MAX_BODY_LEN 60

// Const
enum MsgDir {
  IN,
  OUT
};

struct Msg {
  char body[MAX_BODY_LEN];
  MsgDir dir;
};

struct MessageThread {
  char phoneNumber[MAX_PHONE_LEN];
  Msg messages[MAX_MESSAGES_PER_CONVO];
  int lastMessageIndex;
};


// API
void pushMessage(const char *phone, const char *text, MsgDir dir);

void openConversation(int selection);
void uiTick(const ScreenPoint& sp, bool touched);


void convo();


#endif
