cmtangeman/textmachine/(commit log)

2026-01-21 Inital commit
    [Adafruit TFT 2.8in Resistive Touchshield rev E.brd, Adafruit TFT 2.8in Resistive Touchshield rev E.sch, HA_CrankPhone.brd, HA_CrankPhone.sch, HA_FONA_LARA_20.brd, HA_FONA_LARA_20.kicad_sch, HA_FONA_LARA_20.sch, MKN-LCD.kicad_pcb]
2026-01-31 Removed crankphone stuff, creating a cleaner repository with just text machine stuff
    [Adafruit TFT 2.8in Resistive Touchshield rev E.brd, Adafruit TFT 2.8in Resistive Touchshield rev E.sch, HA_CrankPhone.brd, HA_CrankPhone.sch, HA_FONA_LARA_20.brd, HA_FONA_LARA_20.kicad_sch, HA_FONA_LARA_20.sch, MKN-LCD.kicad_pcb]
2026-02-06 Adding csv with components descriptioins
    [components.csv]
2026-02-26 Fixed 0,0 garbage reading by adding new debouncing logic
    [keyboard.cpp, keyboard.h, textmach.ino]
2026-02-26 Added new UI_COMPOSE logic such that SEND is no longer the transition variable between msg input and phone number input, instead use standard method of clicking between the two input boxes to switch 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
    [keyboard.cpp, keyboard.h, textmach.ino]
2026-03-15 Reworking Messages and conversation modules, fixed touch bleedthrough for conversation and messages
    [keyboard.cpp, messages.cpp, messages.h, textmach.ino]
2026-04-02 Added documentation - Design idea is to go off of crankLight altering the dimensions to match the TFT LCD touchscreen
    [BOM.csv, components.csv]
2026-05-18 Added timestamp logic for messages and cleand up message thread logic. TODO for tommmorow: implement contact logic using serial monitor and SD card non volatile memory storage with csv file [4 hours]
2026-07-08 Added UI improvements to messages state and UI gimmick that shows yellow circle when message is clicked on, eventually this will be a snapchat style thing which is essentially a flag saying -> Next t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
    [UI.cpp, buttons.cpp, buttons.h, messages.cpp, messages.h, textmachcap.ino]
2026-07-27 Refresh button back
2026-08-30 Added new analog switch based power saving mode enabling which shuts off the display, touch, and puts the MCU into deepsleep mode using the Arduino Low Power library, pin 1 is the pin that when drive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
2026-09-01 Changes to enterSleep and exitAndReset that further reduces idle power to around 7mA
2026-09-11 Fixed clock added UI/UX improvements
    [Untitled.kicad_pcb, Untitled.kicad_sch]
2026-09-21 Solid version of FW with screen flipping capabilities and furhter improved UI along with initial .sch and .brd files for the peripheral circuit
2026-10-17 Ported arduino to platformIO and 3 phase dynamo seciton of peripheral board done
2026-10-18 Progress on HW .sch and .brd, with good portion of peripheral board finished, BQ25185 section incomplete and rocker switch section incomplete
