cmtangeman/textmachine/(notices)

Notices in the files:
HW/Buck_5v_sparkfun/Buck_5v_sparkfun.kicad_sch:
Released under the Creative Commons
https://creativecommons.org/licenses/by-sa/4.0
parts and their libraries:
microbuilder: This work is placed in the public domain, and may be freely used for commercial and non-commercial work with the following conditions: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
Arduino-transistors: Copyright (c) 2016-2017 Arduino LLC. All right reserved.
